waynegramlich/mbino/README.md

# MBino

MBino is a Maker Bus version of an "Arduino".

The [documentation](http://gramlich.net/projects/mbino/index.html)
is maintained in HTML format.
