waynegramlich/mbino/rev_a/mbino.sch

## KiCad design rev_a/mbino.sch (2013-07-27, an earlier design)

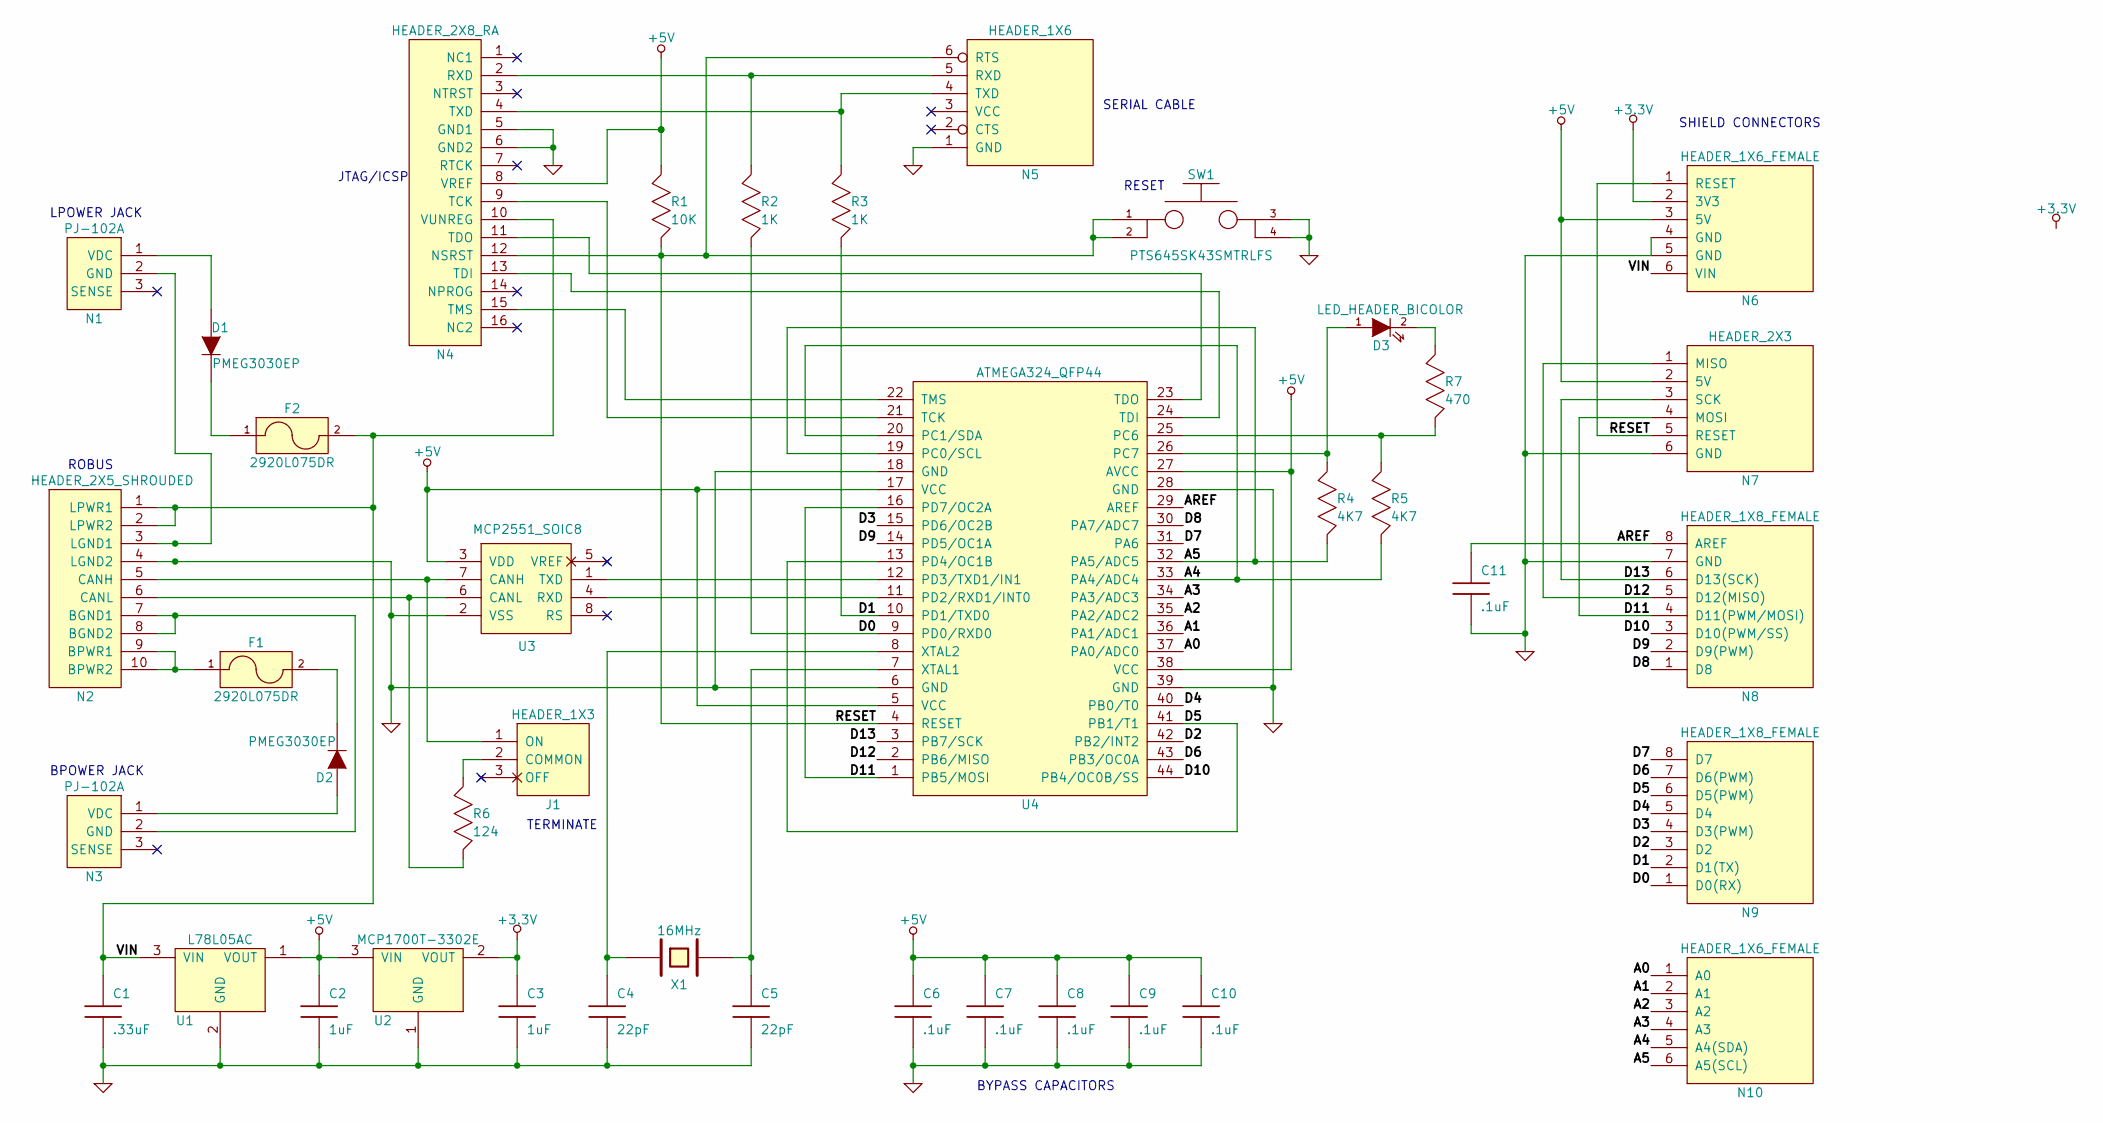
[picture p1: schematic mbino.sch]

Parts:
C1: .33uF
C2, C3: 1uF
C4, C5: 22pF
C6, C7, C8, C9, C10, C11: .1uF
D1, D2: PMEG3030EP
D3: LED_HEADER_BICOLOR
F1, F2: 2920L075DR
J1: HEADER_1X3
N1, N3: PJ-102A
N2: HEADER_2X5_SHROUDED
N4: HEADER_2X8_RA
N5: HEADER_1X6
N6, N10: HEADER_1X6_FEMALE
N7: HEADER_2X3
N8, N9: HEADER_1X8_FEMALE
R1: 10K
R2, R3: 1K
R4, R5: 4K7
R6: 124
R7: 470
SW1: PTS645SK43SMTRLFS
U1: L78L05AC
U2: MCP1700T-3302E
U3: MCP2551_SOIC8
U4: ATMEGA324_QFP44
X1: 16MHz

Connections:
+3.3V: C3.1, N6.2 (3V3), U2.2 (VOUT)
+5V: C2.1, C6.1, C7.1, C8.1, C9.1, C10.1, N4.8 (VREF), N6.3 (5V), N7.2 (5V), R1.2, U1.1 (VOUT), U2.3 (VIN), U3.3 (VDD), U4.5 (VCC), U4.17 (VCC), U4.27 (AVCC), U4.38 (VCC)
A0: N10.1 (A0), U4.37 (PA0/ADC0)
A1: N10.2 (A1), U4.36 (PA1/ADC1)
A2: N10.3 (A2), U4.35 (PA2/ADC2)
A3: N10.4 (A3), U4.34 (PA3/ADC3)
A4: N10.5 (A4(SDA)), R5.1, U4.20 (PC1/SDA), U4.33 (PA4/ADC4)
A5: N10.6 (A5(SCL)), R4.1, U4.19 (PC0/SCL), U4.32 (PA5/ADC5)
AREF: C11.1, N8.8 (AREF), U4.29 (AREF)
D0: N9.1 (D0(RX)), R2.1, U4.9 (PD0/RXD0)
D1: N9.2 (D1(TX)), R3.1, U4.10 (PD1/TXD0)
D2: N9.3 (D2), U4.42 (PB2/INT2)
D3: N9.4 (D3(PWM)), U4.15 (PD6/OC2B)
D4: N9.5 (D4), U4.40 (PB0/T0)
D5: N9.6 (D5(PWM)), U4.13 (PD4/OC1B), U4.41 (PB1/T1)
D6: N9.7 (D6(PWM)), U4.43 (PB3/OC0A)
D7: N9.8 (D7), U4.31 (PA6)
D8: N8.1 (D8), U4.30 (PA7/ADC7)
D9: N8.2 (D9(PWM)), U4.14 (PD5/OC1A)
D10: N8.3 (D10(PWM/SS)), U4.44 (PB4/OC0B/SS)
D11: N7.4 (MOSI), N8.4 (D11(PWM/MOSI)), U4.1 (PB5/MOSI), U4.16 (PD7/OC2A)
D12: N7.1 (MISO), N8.5 (D12(MISO)), U4.2 (PB6/MISO)
D13: N7.3 (SCK), N8.6 (D13(SCK)), U4.3 (PB7/SCK)
GND: C1.2, C2.2, C3.2, C4.2, C5.2, C6.2, C7.2, C8.2, C9.2, C10.2, C11.2, N2.4 (LGND2), N4.5 (GND1), N4.6 (GND2), N5.1 (GND), N6.4 (GND), N6.5 (GND), N7.6 (GND), N8.7 (GND), SW1.3, SW1.4, U1.2 (GND), U2.1 (GND), U3.2 (VSS), U4.6 (GND), U4.18 (GND), U4.28 (GND), U4.39 (GND)
unnamed: C4.1, U4.8 (XTAL2), X1.1
unnamed: C5.1, U4.7 (XTAL1), X1.2
unnamed: D1.1 (A), N1.1 (VDC)
unnamed: D1.2 (K), F2.1
unnamed: D2.1 (A), N3.1 (VDC)
unnamed: D2.2 (K), F1.2
unnamed: D3.1 (A), R4.2, U4.26 (PC7)
unnamed: D3.2 (K), R7.2
unnamed: F1.1, N2.9 (BPWR1), N2.10 (BPWR2)
unnamed: J1.1 (ON), N2.5 (CANH), U3.7 (CANH)
unnamed: J1.2 (COMMON), R6.2
unnamed: N1.2 (GND), N2.3 (LGND1)
unnamed: N2.6 (CANL), R6.1, U3.6 (CANL)
unnamed: N2.7 (BGND1), N2.8 (BGND2), N3.2 (GND)
unnamed: N4.2 (RXD), N5.5 (RXD), R2.2
unnamed: N4.4 (TXD), N5.4 (TXD), R3.2
unnamed: N4.9 (TCK), U4.21 (TCK)
unnamed: N4.11 (TDO), U4.23 (TDO)
unnamed: N4.13 (TDI), U4.24 (TDI)
unnamed: N4.15 (TMS), U4.22 (TMS)
unnamed: R5.2, R7.1, U4.25 (PC6)
unnamed: U3.1 (TXD), U4.12 (PD3/TXD1/IN1)
unnamed: U3.4 (RXD), U4.11 (PD2/RXD1/INT0)
RESET: N4.12 (NSRST), N5.6 (RTS), N6.1 (RESET), N7.5 (RESET), R1.1, SW1.1, SW1.2, U4.4 (RESET)
VIN: C1.1, F2.2, N2.1 (LPWR1), N2.2 (LPWR2), N4.10 (VUNREG), N6.6 (VIN), U1.3 (VIN)

Notes on the sheet:
SHIELD CONNECTORS
JTAG/ICSP
ROBUS
LPOWER JACK
BPOWER JACK
RESET
SERIAL CABLE
TERMINATE
BYPASS CAPACITORS
