waynegramlich/mbino/rev_c/mbino.sch

## KiCad design rev_c/mbino.sch (2013-07-28)

Schematic: mbino.sch

Parts:
C1, C12: 1uF
C2: .33uF
C3: 2.2uF
C4, C5: 22pF
C6, C7, C8, C9, C10, C11, C13, C14: .1uF
D1, D2: PMEG3015EH
D3: LED_HEADER_BICOLOR
D4: LG_R971-KN-1-0-20-R18
F1, F2: 0ZCC0110FF2C
H1, H2, H3, H4, H5, H6, H7, H8: M3.0_#4_HOLE
J1: HEADER_1X3
N1, N3: PJ-102A
N2: HEADER_2X5_SHROUDED_RA
N4: HEADER_2X8_RA
N5: HEADER_1X6
N6, N10: HEADER_1X6_FEMALE
N7: HEADER_2X3
N8, N9: HEADER_1X8_FEMALE
R1, R11: 10K
R2, R3: 1K
R4, R5: 4K7
R6: 124
R7, R8: 470
R9: 24K
R10: 180
SW1: KSS221GLFS
U1: L78L05CDT-TR
U2: MCP1700T-3302E-SOT89
U3: MCP2551_SOIC8
U4: ATMEGA324_QFP44
U5: 74x2G06
X1: 16MHz

Notes on the sheet:
SHIELD CONNECTORS
JTAG/ICSP
ROBUS
LPOWER JACK
BPOWER JACK
RESET
SERIAL CABLE
TERMINATE
BYPASS CAPACITORS
