waynegramlich/mbino/(commit log)

2013-07-27 Checked files into git.
    [mbino.brd, mbino.sch]
2013-07-27 Upgraded Rev. B to s-expression .brd format.
    [mbino.brd]
2013-07-27 Added rev. C
    [mbino.brd, mbino.sch]
2013-07-27 Minor modifications to revision C.
    [mbino.brd]
2013-07-28 Added MakerBus reset circuit.
    [mbino.brd, mbino.sch]
